SuperFabius/CPLD-Fun-Board/README.md

# CPLD Fun Board
Homemade low cost CPLD dev board (Arduino STM32F103 and Altera MAX II EPM240/EPM570 CPLD). Two dev boards into one. 

More info here: https://hackaday.io/project/27062-arduino-cpld-cpld-fun-board

All the project files (SW & HW) are licensed under GPL v3.
