SuperFabius/CPLD-Fun-Board/A020216-R280617 BOM.ods

Reference | Package | Quantity | Value/Designation | Toll.
C11,C13 | SMD 0805 Ceramic | 2 | 22pF 6.3V
C12 | THP Radial Electrolitic | 1 | 100uF 10V
C10,C9 | SMD 0805 Ceramic | 2 | 100nF 6.3V
C21,C5 | SMD 0805 Ceramic | 2 | 10uF 6.3V
C15 | SMD 0805 Ceramic | 1 | 100nF 10V
C6,C14,C16 | SMD 0805 Ceramic | 3 | 10uF 10V
C35,C33,C4,C3,C30,C29,C28,C27,C26,C25,C24,C23,C2,C1,C31 | SMD 0402 Ceramic | 15 | 100nF 6.3V
C7,C22,C34,C20,C32,C19,C18,C17 | SMD 0805 Ceramic | 8 | 1uF 6.3V
C8 | SMD 0402 Ceramic | 1 | 1uF 6.3V
D1,D5,D4,D3 | SMD DO-214AC | 4 | 1N5817
D2 | SMD DO-214AC | 1 | 1N4001
D7,D8,D9,D10,D12,D11,D6 | SMD SOD80C | 7 | 1N4148
J1 | DC BARREL JACK | 1 | 5V Ext DC In
J10 | Pin_Header_Straight_1x02 | 1 | EXTCLK1
J11 | Pin_Header_Straight_1x02 | 1 | EXTCLK2
J12 | Pin_Header_Straight_1x15 | 1 | GPIO1
J13 | Pin_Header_Straight_1x15 | 1 | GPIO2
J2 | USB B Connector | 1 | USB
J3 | Pin_Header_Straight_1x04 | 1 | SWD
J4 | Pin_Header_Straight_1x04 | 1 | Serial-USB
J5 | Pin_Header_Straight_1x16 | 1 | LCD 1602A/2004A
J6 | Pin_Header_Straight_1x08 | 1 | TEST1
J7 | Pin_Header_Straight_1x08 | 1 | TEST2
J8 | Pin_Header_Straight_1x07 | 1 | TEST3
J9 | IDC_Header_Straight_10pins | 1 | ALTERA-JTAG-10
JP1 | Pin_Header_Straight_1x02 | 1 | BOOT1
JP2 | Pin_Header_Straight_1x03 | 1 | VDISP_SEL
L1 | LED-3mm | 1 | POWER
L2 | LED-3MM | 1 | LED
L3 | KW4361 4 Digit 7 segment Comm. Cath or equivalent | 1 | 3641AS
L4 | LED-3mm | 1 | LED1
L5 | LED-3mm | 1 | LED3
L6 | LED-3mm | 1 | LED2
L7 | LED-3mm | 1 | LED4
L8 | LED-3mm | 1 | DEV_OE
Q1 | SMD SOT23 | 1 | MMBT2907
Q6,Q5,Q4,Q3,Q2 | SMD SOT23 | 5 | MMBT2222
R11,R10,R9 | SMD 0805 | 3 | 33 | 5%
R14,R13 | SMD 0805 | 2 | 22 | 5%
R15 | SMD 0805 | 1 | 47k | 5%
R2 | SMD 0805 | 1 | 4k7 | 5%
R29,R28,R27,R26,R67,R64,R65,R33,R32,R31,R30 | SMD 0805 | 11 | 33k | 5%
R41,R40,R39,R38,R37,R36,R35,R34 | SMD 0805 | 8 | 68 | 5%
R45,R44,R43,R42 | SMD 0805 | 4 | 300 | 5%
R46,R1 | SMD 0805 | 2 | 470 | 5%
R47 | SMD 0805 | 1 | 39 | 5%
R52,R16 | SMD 0805 | 2 | 1k5 | 5%
R58,R57,R56,R55,R54,R53,R21,R20,R19,R18 | SMD 0805 | 10 | 2k2 | 5%
R61,R8,R6,R4 | SMD 0805 | 4 | 1k | 5%
R63,R62,R51,R50,R49,R48,R5,R60,R59,R12,R3 | SMD 0805 | 11 | 10k | 5%
R66 | SMD 0805 | 1 | 0R | 5%
R68 | SMD 0805 | 1 | 270 | 5%
R69 | SMD 0805 | 1 | 82k | 5%
R7,R25,R24,R23,R22,R17 | SMD 0805 | 6 | 220 | 5%
SJ3,SJ4,SJ6,SJ8,SJ5,SJ7,SJ1,SJ2 | Solder_Bridge | 8 | Solder_Bridge
SW1 | Push button | 1 | USR1
SW10 | SPST switch | 1 | DEV_OE
SW11 | Push button | 1 | DEV_CLRn
SW2 | Push button | 1 | BUT
SW3 | Push button | 1 | RST
SW4 | Push button | 1 | USR2
SW5 | Push button | 1 | USR3
SW6 | Push button | 1 | USR4
SW7 | Push button | 1 | USR5
SW8 | Push button | 1 | USR6
SW9 | Push button | 1 | USR7
U1 | SMD SOT223 | 1 | AMS1117-3.3
U2 | SMD LQFP-48_7x7mm_Pitch0.5mm | 1 | STM32F103C8T6-LQFP48
U3 | SMD TQFP-100_14x14mm_Pitch0.5mm | 1 | EPM240T100C5N/EPM570T100C5N
U4 | SMD 3225 Active Crystal Osc. 50MHz | 1 | OSC-SMD3225
X1 | HC-49V Crystal 8MHz | 1 | 8MHz
